ThaoMinhHoang/350_Flight_controller/README.md

# ECTE350 Flight controller
ECTE350 storage room for Locus team

Save the kicad files of your sensor. Put them into a folder. Name the folder after your sensor. Upload the folder to github.

The Development folder is all of our work in the one kicad file. Be careful when overwriting data!
