ThaoMinhHoang/350_Flight_controller/footprint/NX3225SA-24.000M-STD-CSR-3-pcb-part-libraries/LIB_GET/NX3225SA-24.000M-STD-CSR-3/3D/NX3225SA-24.000M-STD-CSR-3.stp

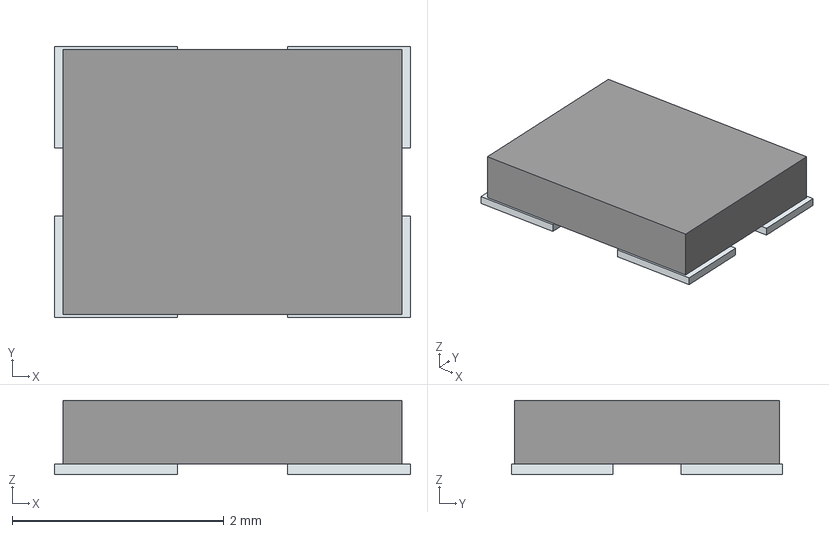
[picture p1: CAD file, 2019-08-31]
footprint/NX3225SA-24.000M-STD-CSR-3-pcb-part-libraries/LIB_GET/NX3225SA-24.000M-STD-CSR-3/3D/NX3225SA-24.000M-STD-CSR-3.stp
3.36 x 2.56 x 0.7 mm
('pin',_'1')
('pin',_'2')
('pin',_'3')
('pin',_'4')
