ThaoMinhHoang/350_Flight_controller/(list of files, cad)

Other CAD files:
footprint/NX3225SA-24.000M-STD-CSR-3-pcb-part-libraries/LIB_GET/NX3225SA-24.000M-STD-CSR-3/3D/NX3225SA-24.000M-STD-CSR-3.stl
footprint/NX3225SA-24.000M-STD-CSR-3-pcb-part-libraries/LIB_GET/NX3225SA-24.000M-STD-CSR-3/Allegro/nx3225sa12000mhzstdcsr1.psm
footprint/NX3225SA-24.000M-STD-CSR-3-pcb-part-libraries/LIB_GET/NX3225SA-24.000M-STD-CSR-3/DEHDL/nx3225sa_24.000m_std_csr_3/chips/chips.prt
footprint/NX3225SA-24.000M-STD-CSR-3-pcb-part-libraries/NX3225SA-24.000M-STD-CSR-3.stl
