ThaoMinhHoang/350_Flight_controller/Development/Flight_Controller.pdf

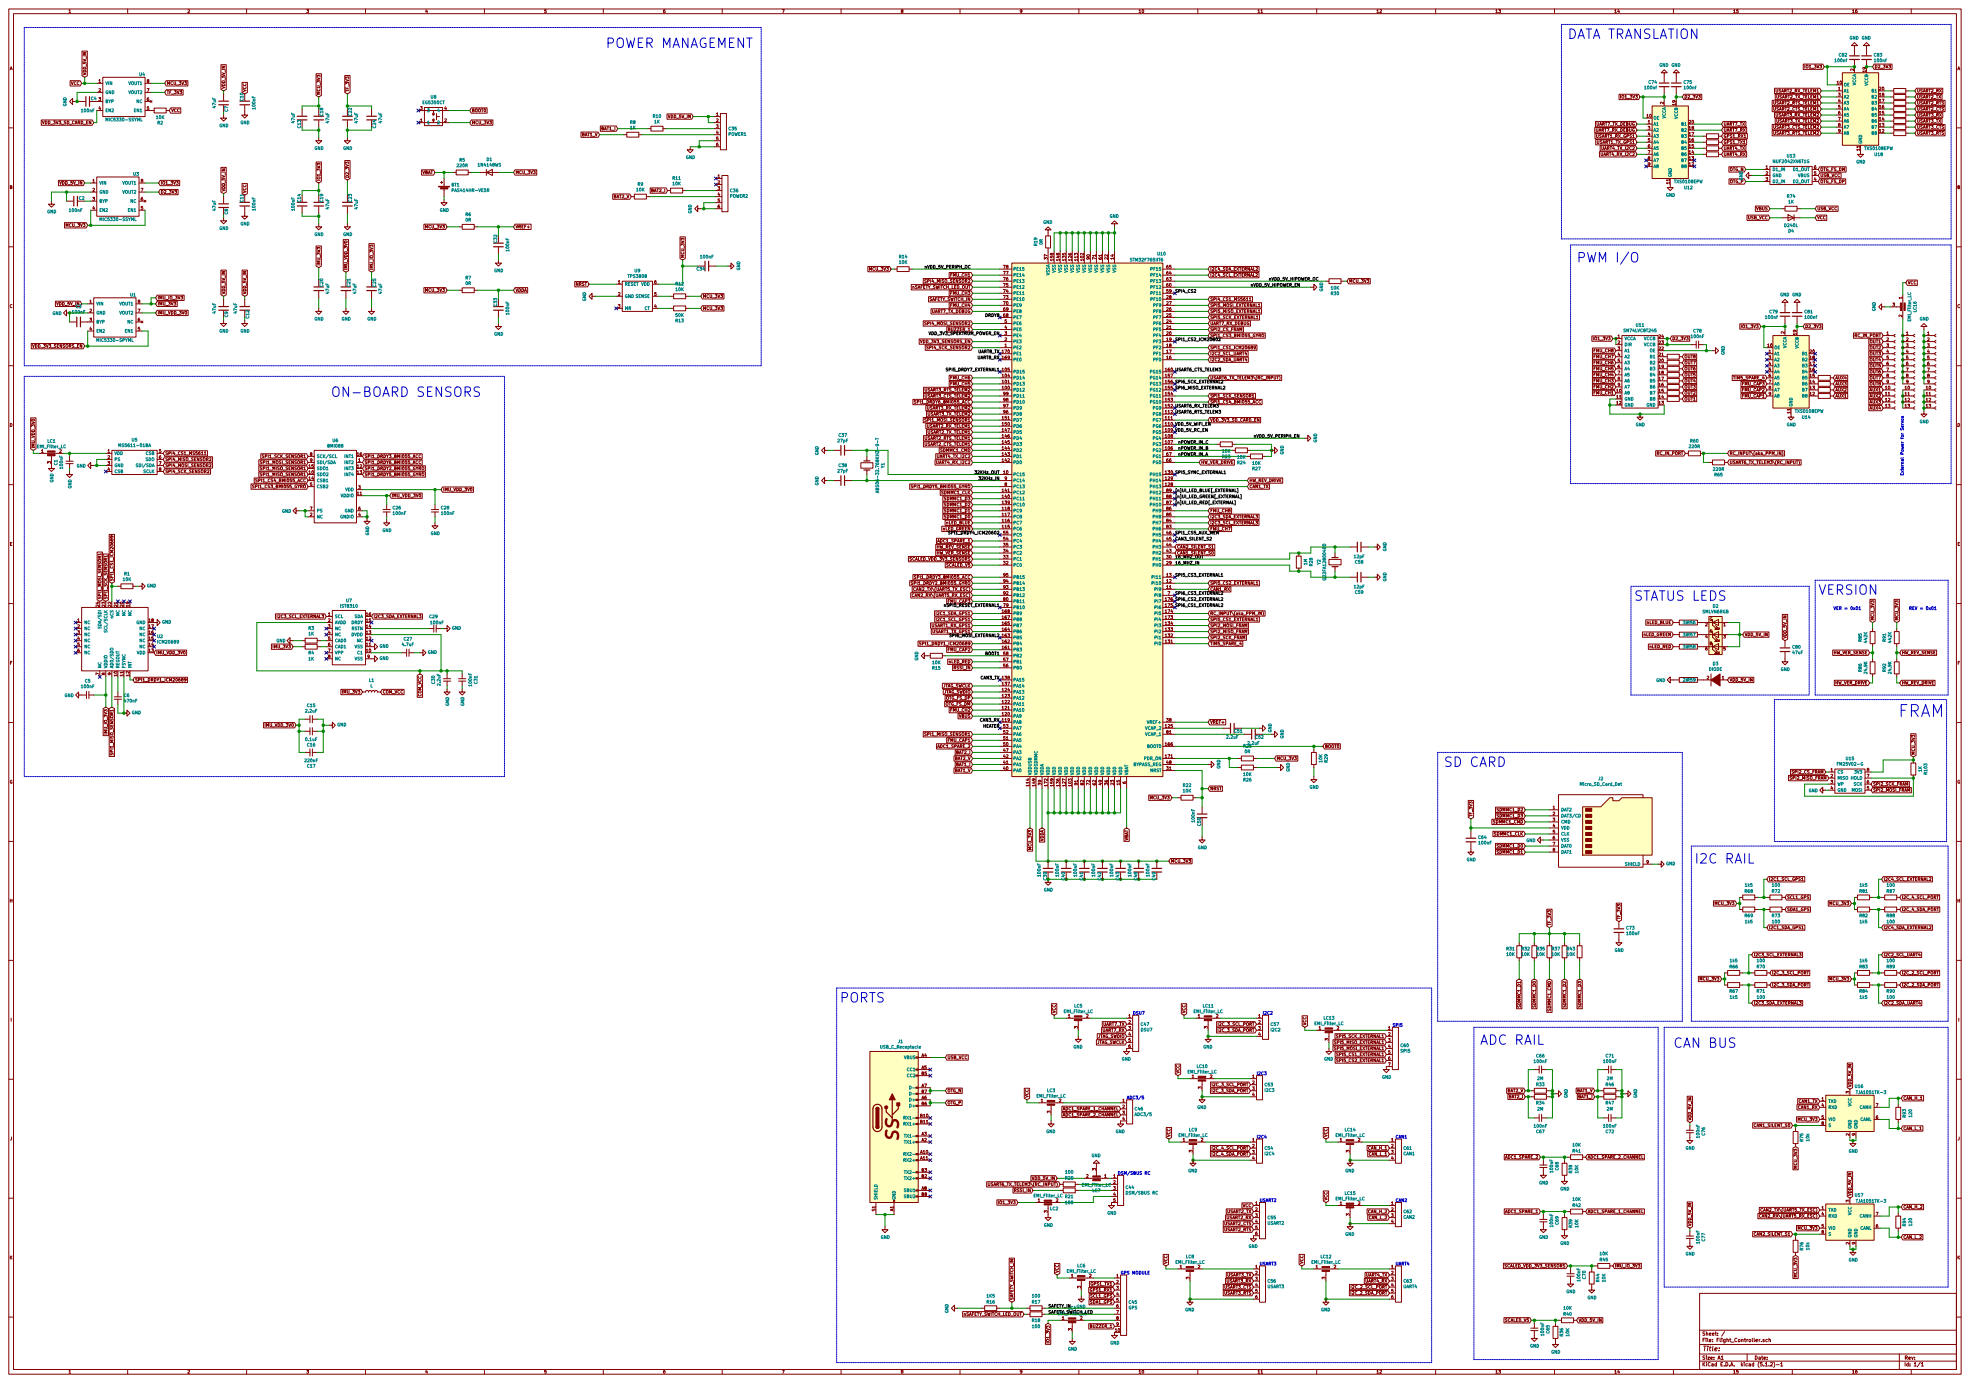
[picture p5: page 1]
