ThaoMinhHoang/350_Flight_controller/Development/Flight_Controller.kicad_pcb

## KiCad design Development/Flight_Controller.kicad_pcb (2019-10-13)

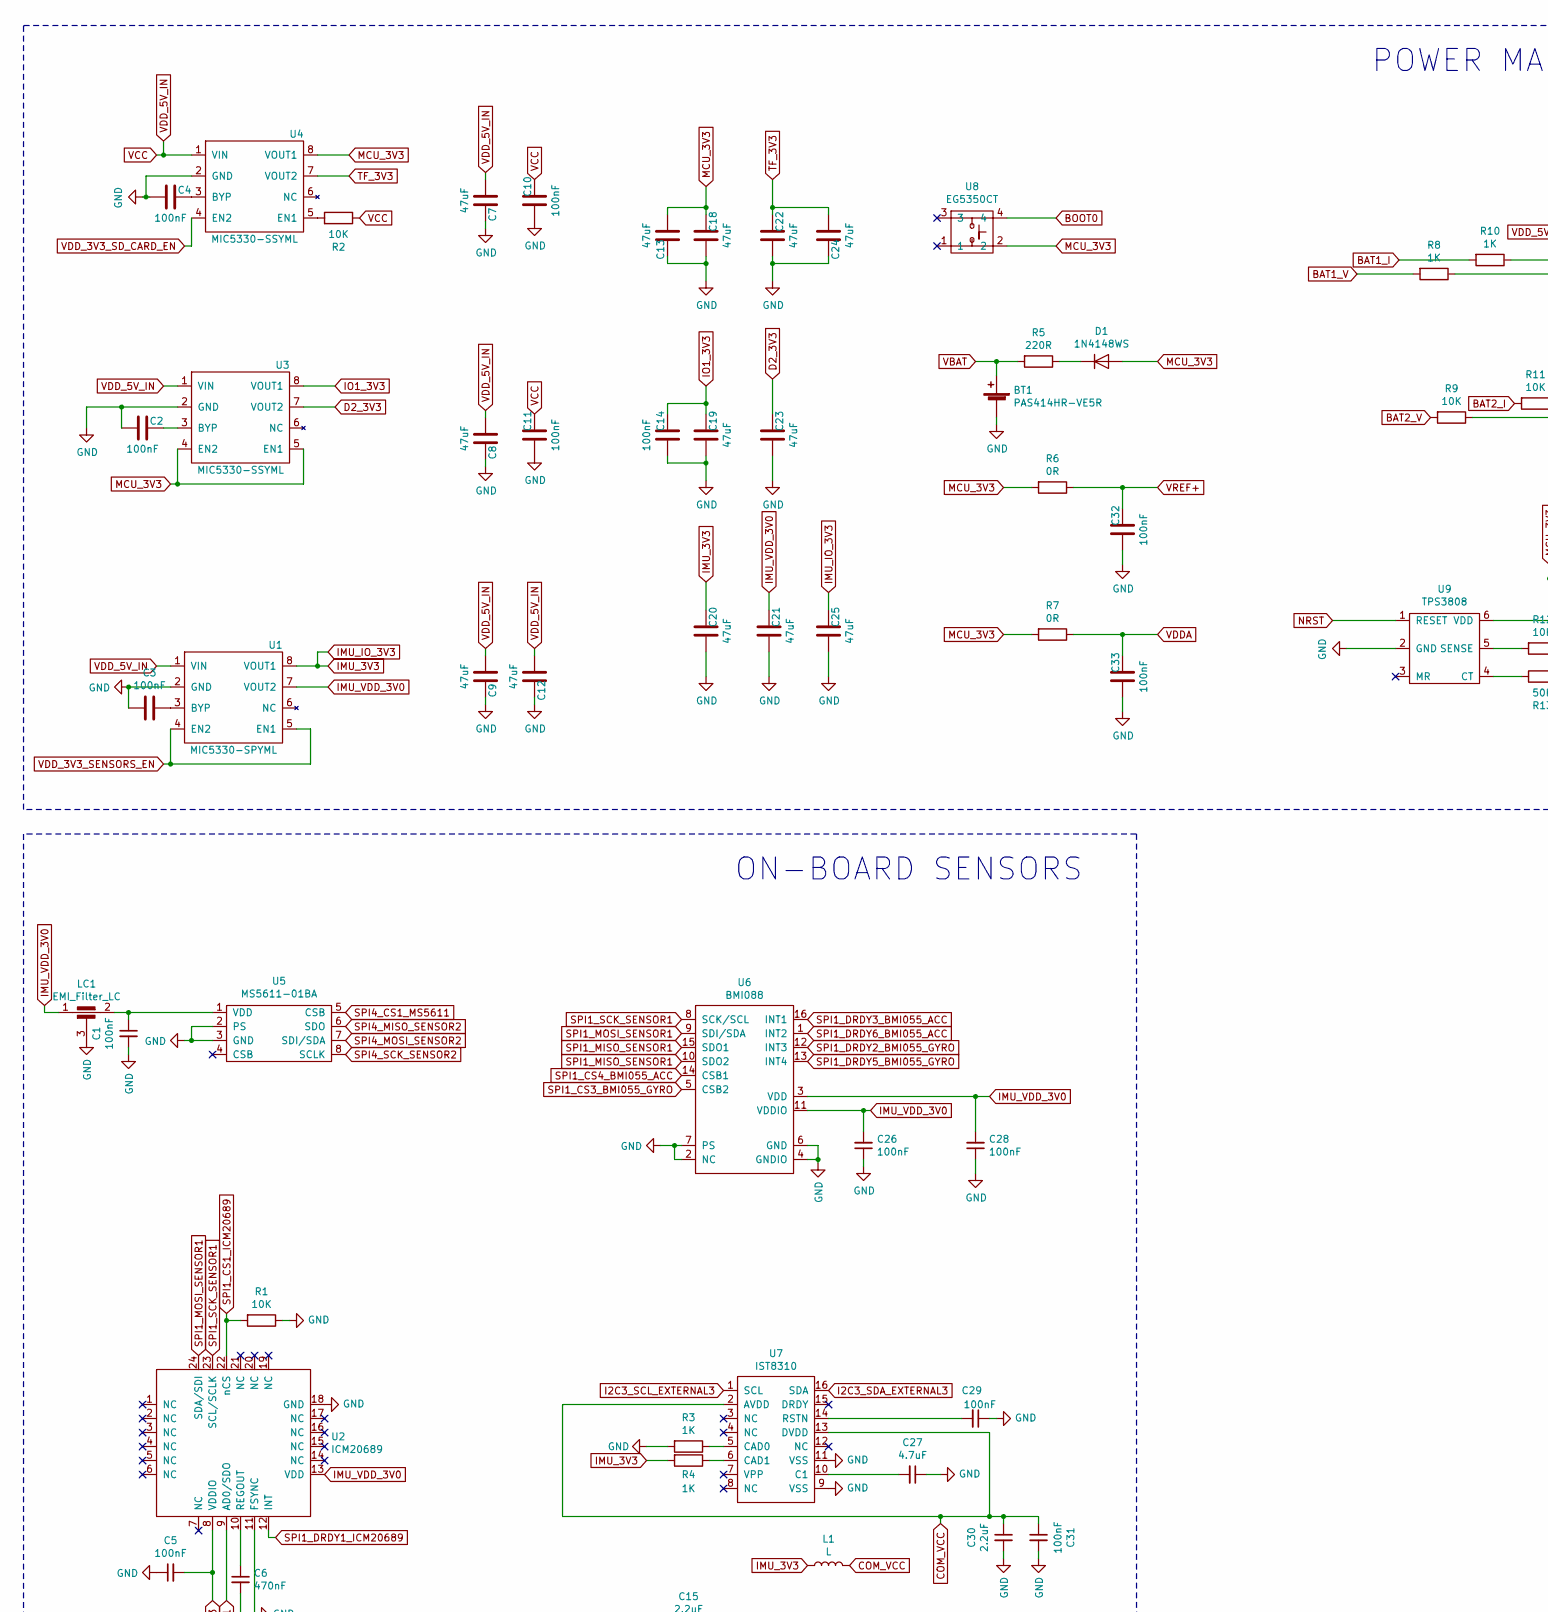
[picture p6: schematic Flight_Controller.sch, part in row 1, column 1]

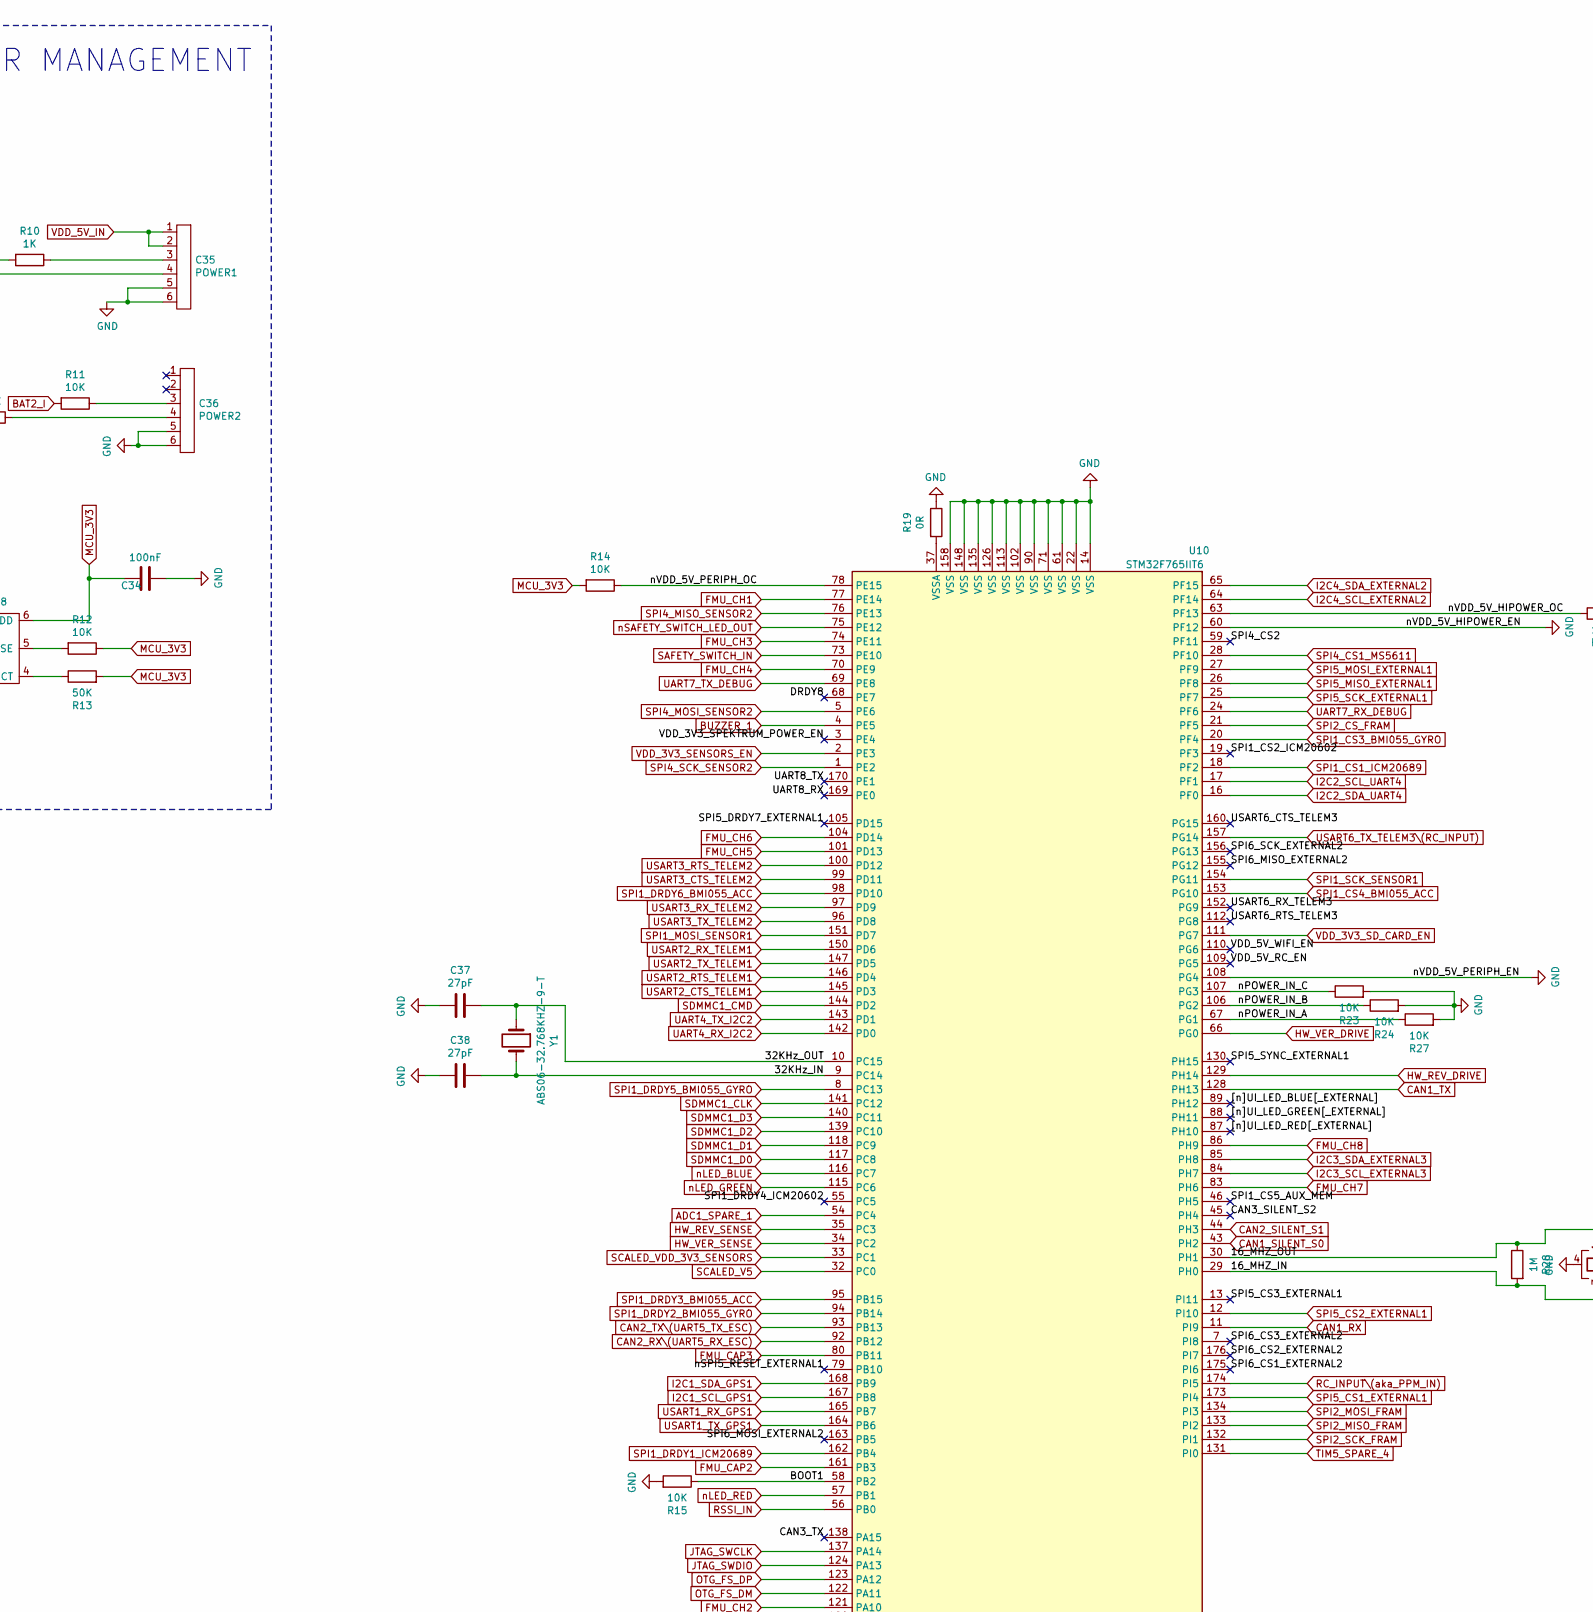
[picture p7: schematic Flight_Controller.sch, part in row 1, column 2]

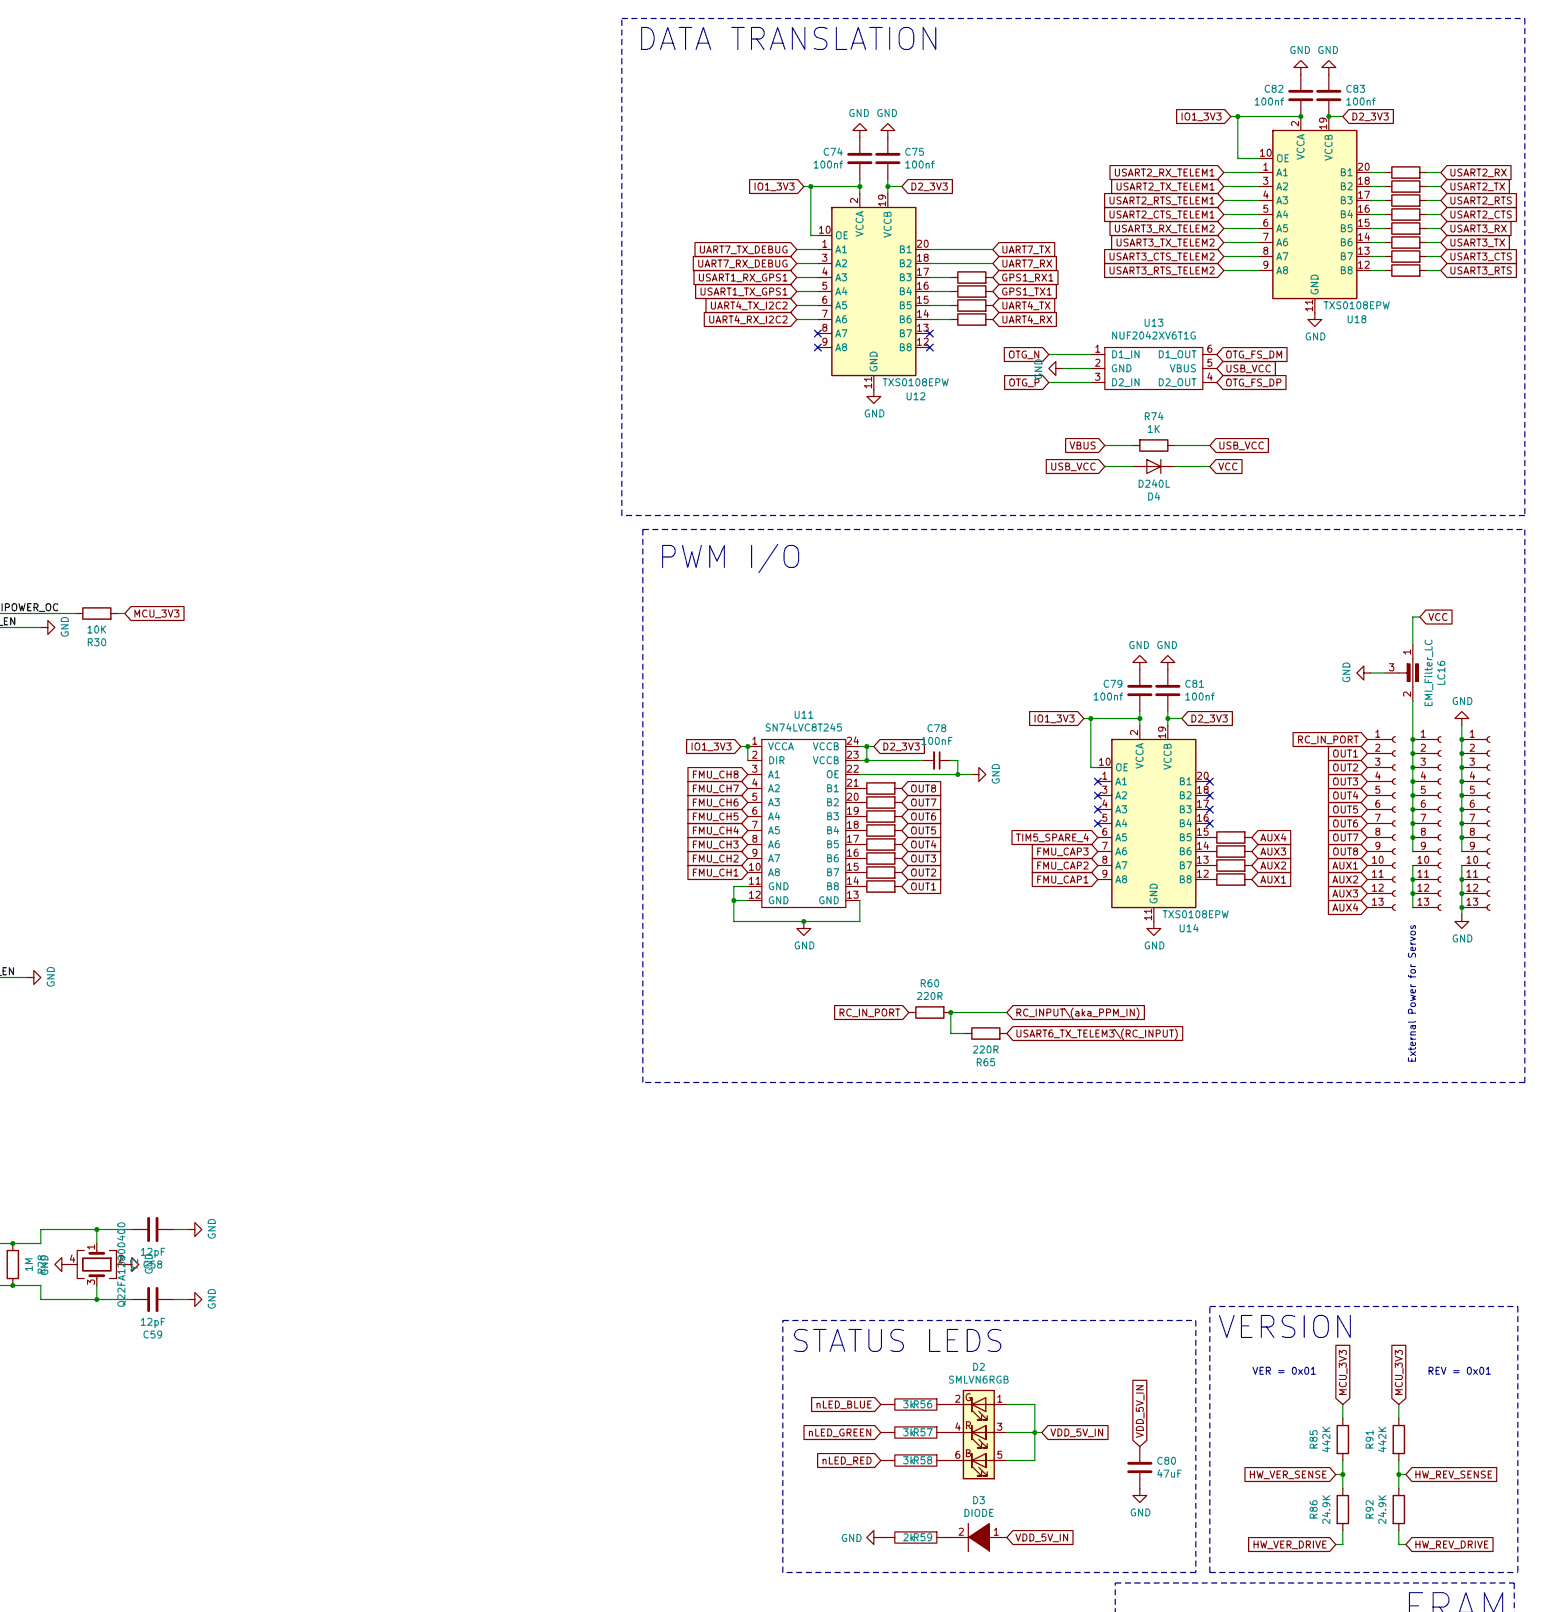
[picture p8: schematic Flight_Controller.sch, part in row 1, column 3]

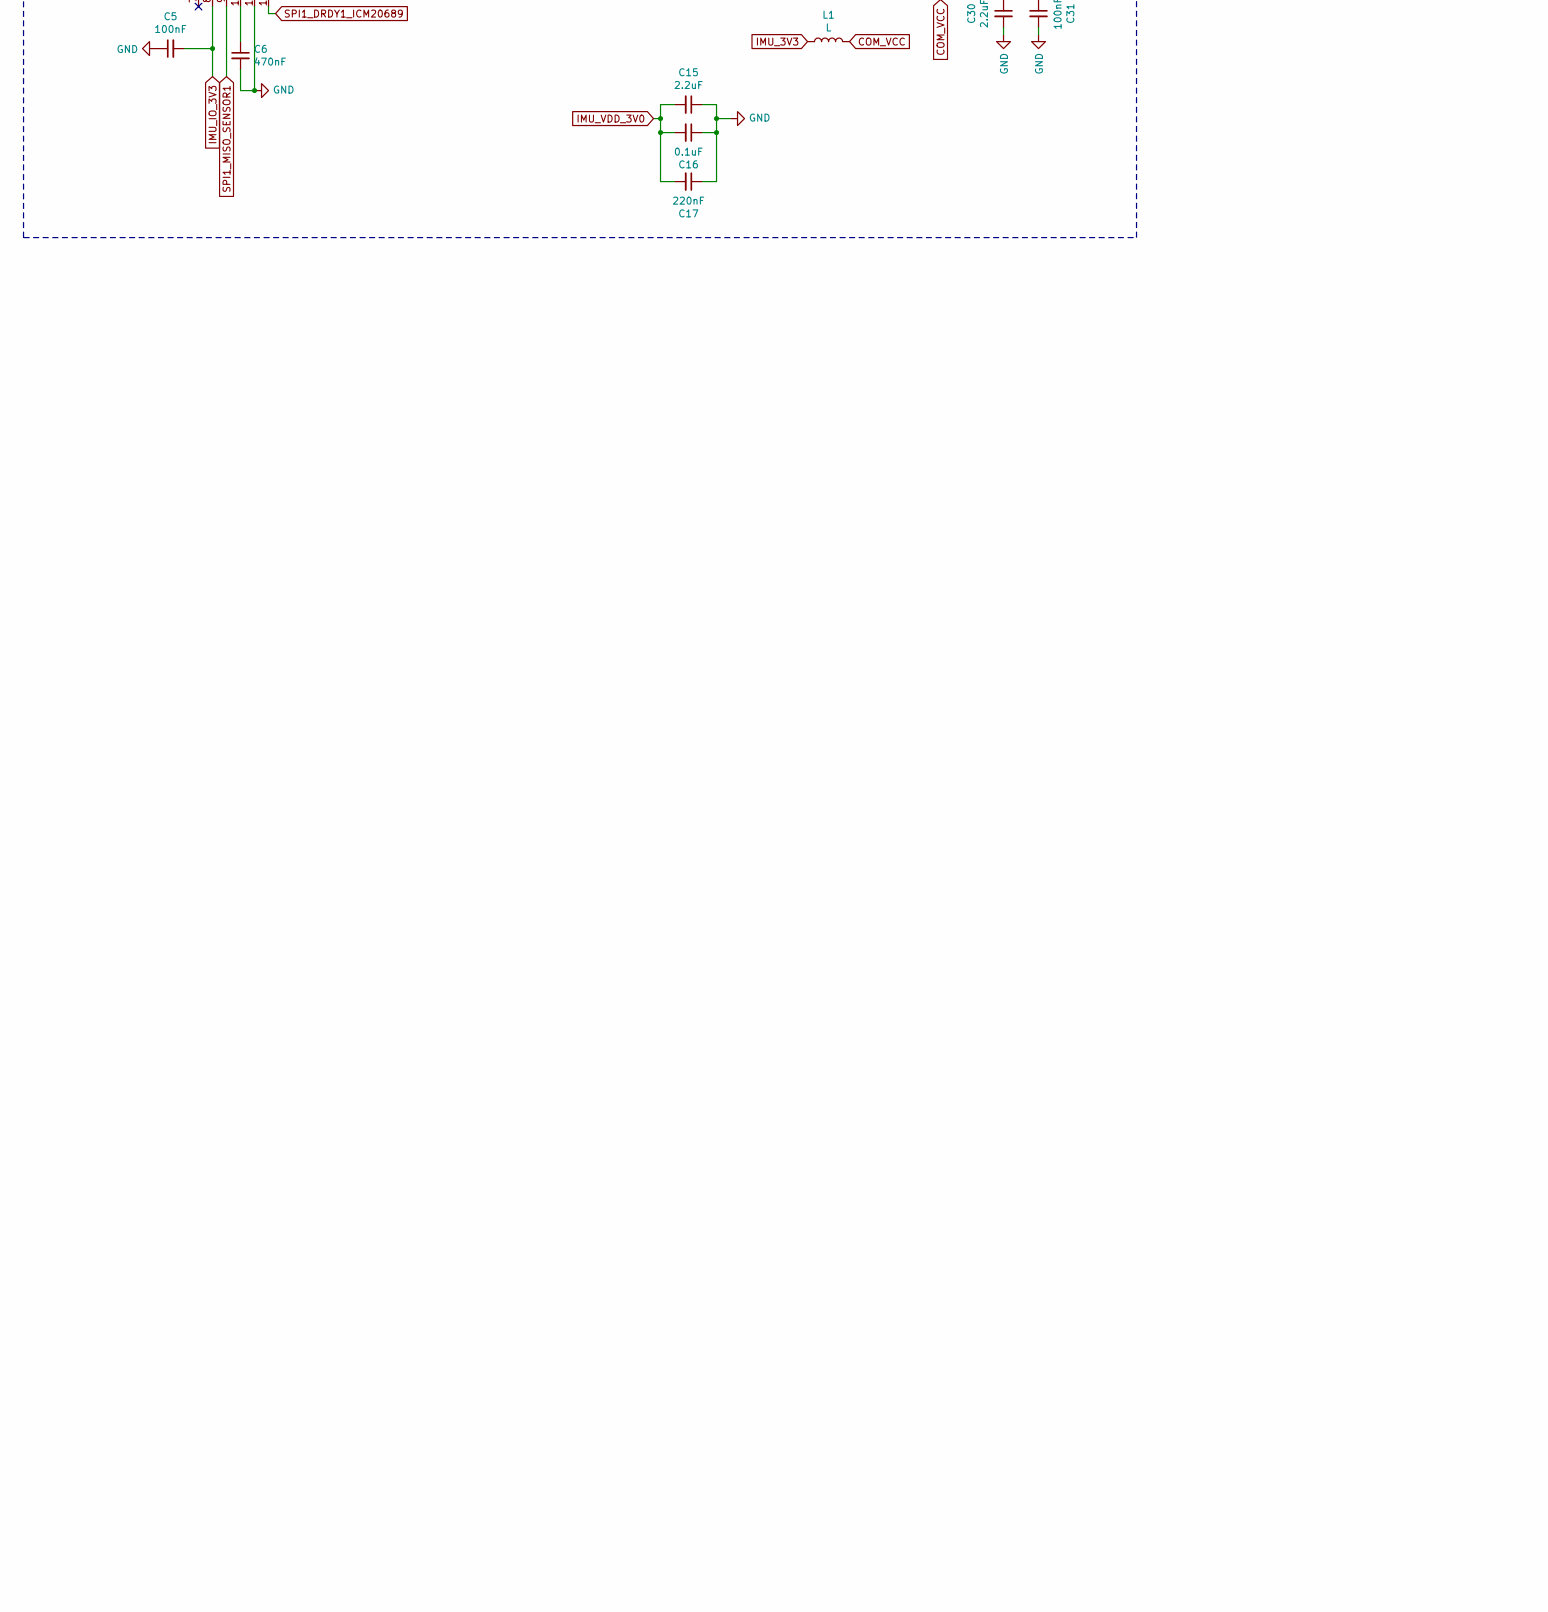
[picture p9: schematic Flight_Controller.sch, part in row 2, column 1]

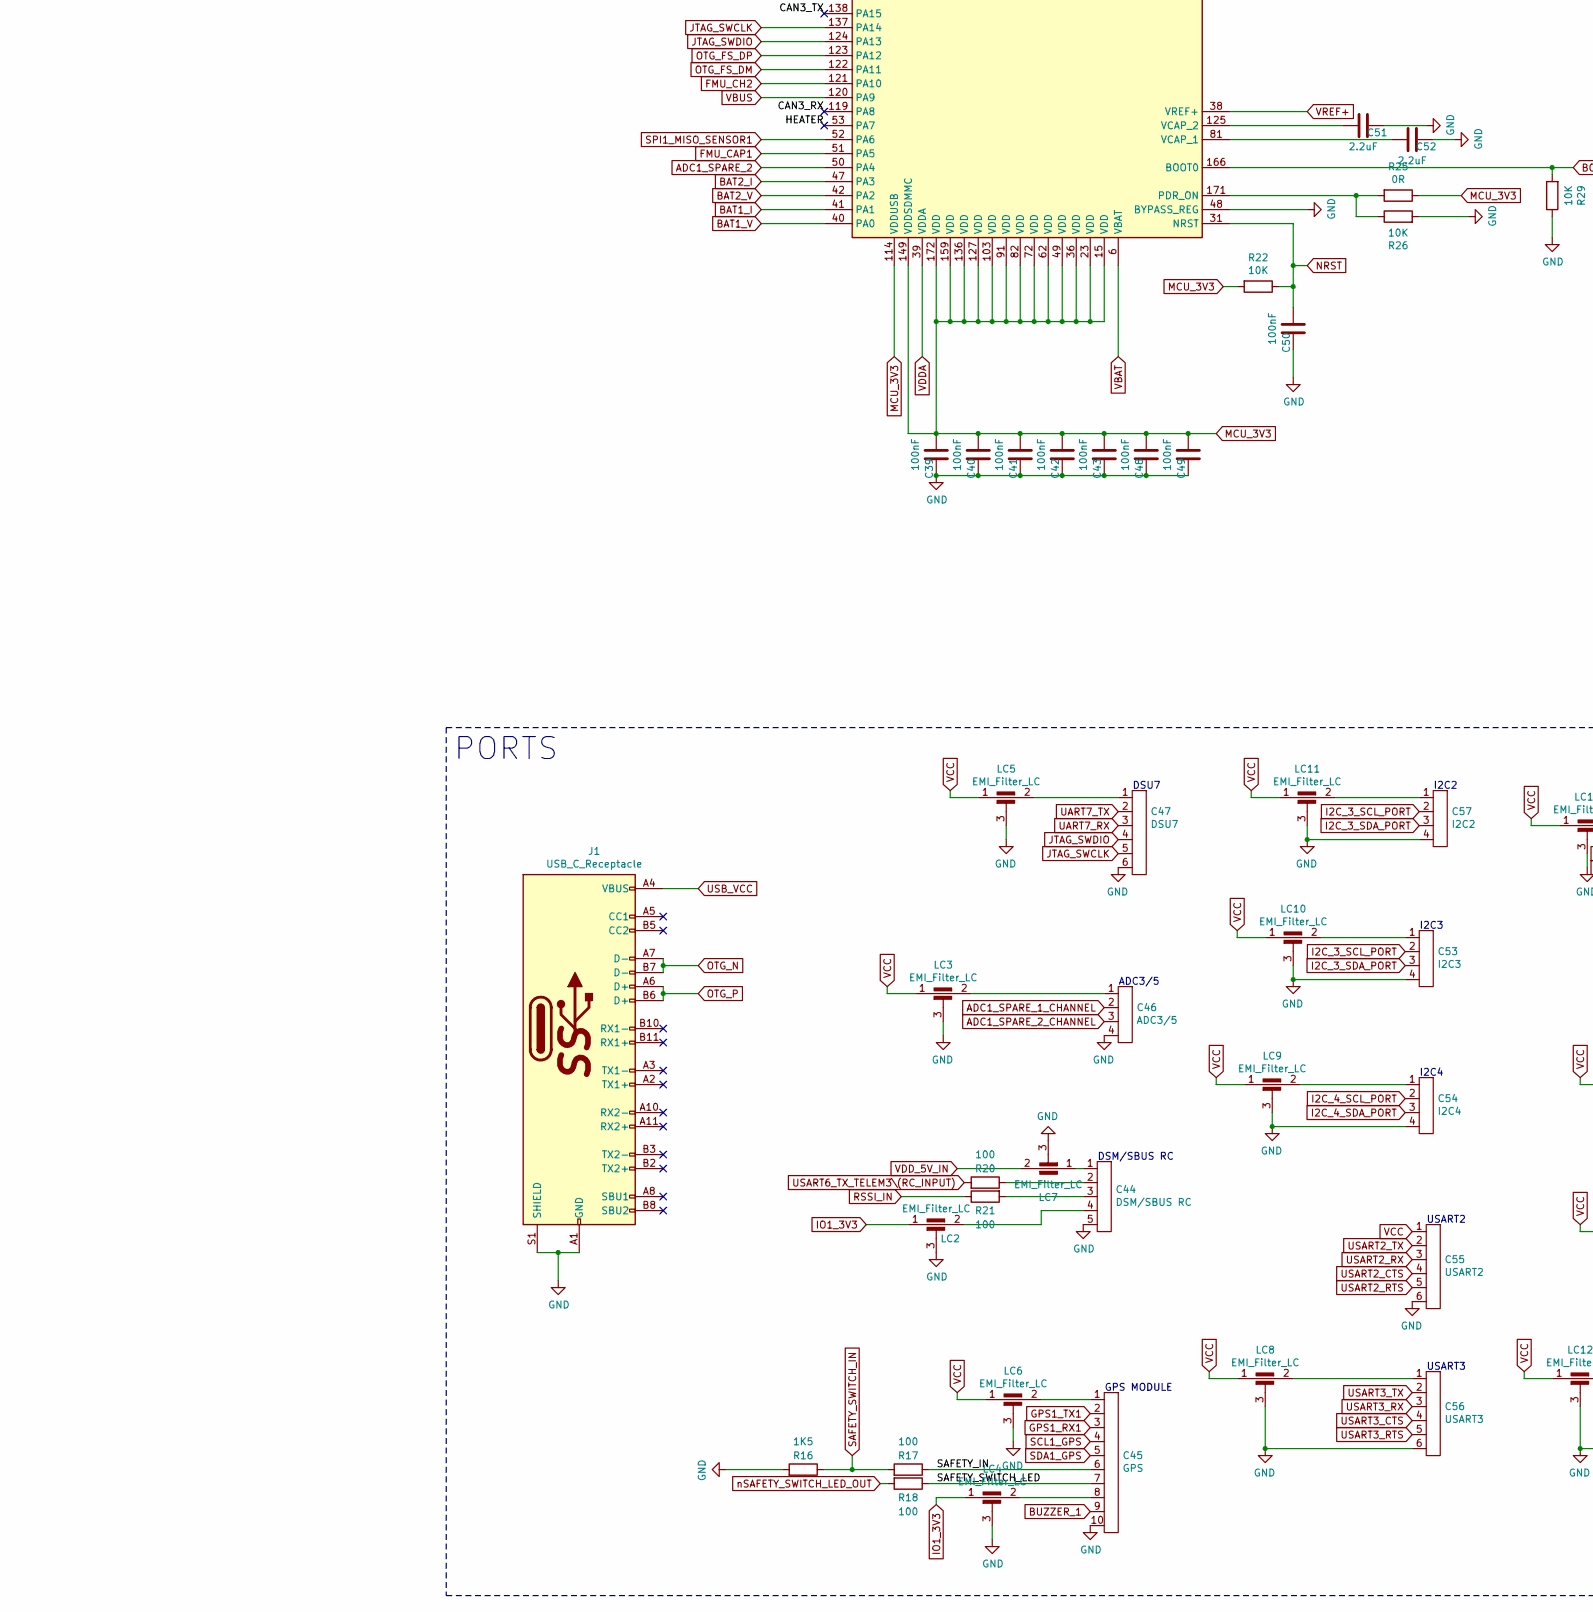
[picture p10: schematic Flight_Controller.sch, part in row 2, column 2]

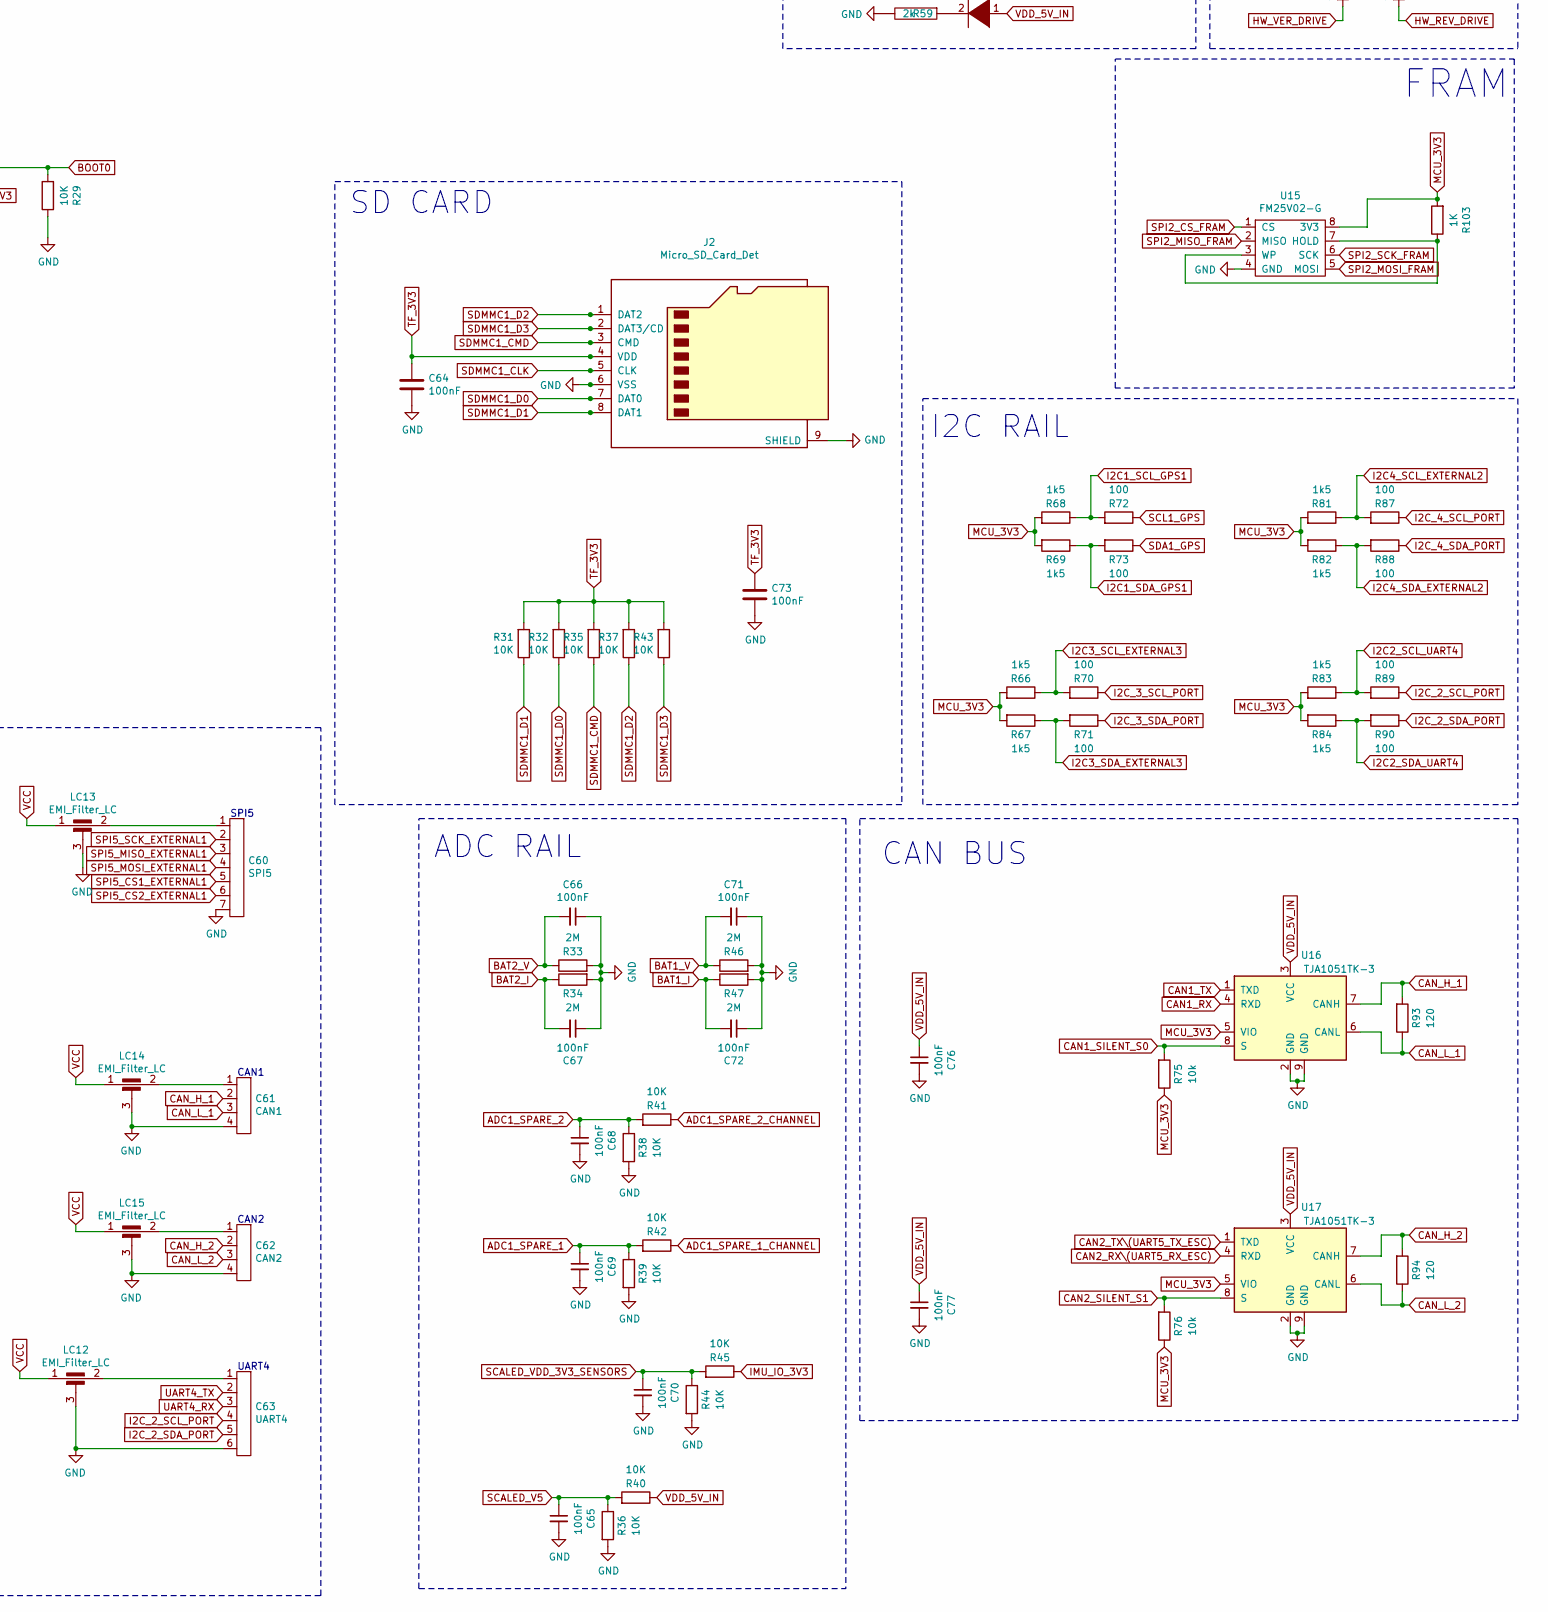
[picture p11: schematic Flight_Controller.sch, part in row 2, column 3]

Parts:
BT1: PAS414HR-VE5R; UL_PAS414HRVE5R
C1, C2, C3, C4, C5, C10, C11, C14, C26, C28, C29, C31, C32, C33, C34, C39, C40, C41, C42, C43, C48, C49, C50, C64, C65, C66, C67, C68, C69, C70, C71, C72, C73, C76, C77, C78: 100nF; C_0402_1005Metric
C6: 470nF; C_0402_1005Metric
C7, C8, C9, C12, C13, C18, C19, C20, C21, C22, C23, C24, C25, C80: 47uF; C_0603_1608Metric
C15, C30, C51, C52: 2.2uF; C_0402_1005Metric
C16: 0.1uF; C_0402_1005Metric
C17: 220nF; C_0402_1005Metric
C27: 4.7uF; C_0402_1005Metric
C35: POWER1; JST_GH_BM06B-GHS-TBT_06x1.25mm_Straight
C36: POWER2; JST_GH_BM06B-GHS-TBT_06x1.25mm_Straight
C37, C38: 27pF; C_0402_1005Metric
C44: DSM/SBUS RC; JST_GH_BM05B-GHS-TBT_05x1.25mm_Straight
C45: GPS; JST_GH_BM10B-GHS-TBT_10x1.25mm_Straight
C46: ADC3/5; JST_GH_BM04B-GHS-TBT_04x1.25mm_Straight
C47: DSU7; JST_GH_BM06B-GHS-TBT_06x1.25mm_Straight
C53: I2C3; JST_GH_BM04B-GHS-TBT_04x1.25mm_Straight
C54: I2C4; JST_GH_BM04B-GHS-TBT_04x1.25mm_Straight
C55: USART2; JST_GH_BM06B-GHS-TBT_06x1.25mm_Straight
C56: USART3; JST_GH_BM06B-GHS-TBT_06x1.25mm_Straight
C57: I2C2; JST_GH_BM04B-GHS-TBT_04x1.25mm_Straight
C58, C59: 12pF; C_0402_1005Metric
C60: SPI5; JST_GH_BM07B-GHS-TBT_07x1.25mm_Straight
C61: CAN1; JST_GH_BM04B-GHS-TBT_04x1.25mm_Straight
C62: CAN2; JST_GH_BM04B-GHS-TBT_04x1.25mm_Straight
C63: UART4; JST_GH_BM06B-GHS-TBT_06x1.25mm_Straight
C74, C75, C79, C81, C82, C83: 100nf; C_0402_1005Metric
D1: 1N4148WS; D_SOD-323
D2: SMLVN6RGB; LED_ROHM_SMLVN6
D3: DIODE; LED_0603_1608Metric
D4: D240L; D_SOD-123
J1: USB_C_Receptacle; USB_C_Receptacle_Amphenol_12401610E4-2A_CircularHoles
J2: Micro_SD_Card_Det; microSD_HC_Hirose_DM3AT-SF-PEJM5
J3, J4, J5: Conn_01x13_Female; PinHeader_1x13_P2.54mm_Vertical
L1: L; L_0402_1005Metric
LC1, LC2, LC3, LC4, LC5, LC6, LC7, LC8, LC9, LC10, LC11, LC12, LC13, LC14, LC15, LC16: EMI_Filter_LC; FIL_NFM21PC105B1C3D
R1, R2, R9, R11, R12, R14, R15, R22, R23, R24, R26, R27, R29, R30, R31, R32, R35, R36, R37, R38, R39, R40, R41, R42, R43, R44, R45: 10K; R_0402_1005Metric
R3, R4, R8, R10, R74, R103: 1K; R_0402_1005Metric
R5, R60, R65: 220R; R_0402_1005Metric
R6, R7, R19, R25: 0R; R_0402_1005Metric
R13: 50K; R_0402_1005Metric
R16: 1K5; R_0402_1005Metric
R17, R18, R20, R21, R48, R49, R50, R51, R52, R53, R54, R55, R70, R71, R72, R73, R77, R78, R79, R80, R87, R88, R89, R90: 100; R_0402_1005Metric
R28: 1M; R_0402_1005Metric
R33, R34, R46, R47: 2M; R_0402_1005Metric
R56, R57, R58: 3k; R_0402_1005Metric
R59: 2k; R_0402_1005Metric
R61, R62, R63, R64, R95, R96, R97, R98, R99, R100, R101, R102: 100R; R_0402_1005Metric
R66, R67, R68, R69, R81, R82, R83, R84: 1k5; R_0402_1005Metric
R75, R76: 10k; R_0402_1005Metric
R85, R91: 442K; R_0402_1005Metric
R86, R92: 24.9K; R_0402_1005Metric
R93, R94: 120; R_0402_1005Metric
U1: MIC5330-SPYML; MIC5330-SSYML-TR
U2: ICM20689
U3, U4: MIC5330-SSYML; MIC5330-SSYML-TR
U5: MS5611-01BA; ms5611
U6: BMI088
U7: IST8310; ist8310
U8: EG5350CT; SW_SPST_EVQP7C
U9: TPS3808; SOT95P280X145-6N
U10: STM32F765IIT6; LQFP-176_24x24mm_P0.5mm
U11: SN74LVC8T245; SOP65P640X120-24N
U12, U14, U18: TXS0108EPW; TSSOP-20_4.4x6.5mm_P0.65mm
U13: NUF2042XV6T1G; SOT50P160X60-6N
U15: FM25V02-G
U16, U17: TJA1051TK-3; DFN-8-1EP_3x3mm_P0.65mm_EP1.55x2.4mm
Y1: ABS06-32.768KHZ-9-T; XTAL_ABS06-32.768KHZ-9-T
Y2: Q22FA12800400

Connections:
/16_MHZ_IN: C59.1, R28.2, U10.29 (PH0), Y2.3
/16_MHZ_OUT: C58.1, R28.1, U10.30 (PH1), Y2.1
/32KHz_IN: C38.1, U10.9 (PC14), Y1.2
/32KHz_OUT: C37.1, U10.10 (PC15), Y1.1
/BOOT1: R15.1, U10.58 (PB2)
/CAN3_RX: U10.119 (PA8)
/CAN3_SILENT_S2: U10.45 (PH4)
/CAN3_TX: U10.138 (PA15)
/DRDY8: U10.68 (PE7)
/HEATER: U10.53 (PA7)
/SAFETY_IN: C45.6, R17.1
/SAFETY_SWITCH_LED: C45.7, R18.1
/SPI1_CS2_ICM20602: U10.19 (PF3)
/SPI1_CS5_AUX_MEM: U10.46 (PH5)
/SPI1_DRDY4_ICM20602: U10.55 (PC5)
/SPI4_CS2: U10.59 (PF11)
/SPI5_CS3_EXTERNAL1: U10.13 (PI11)
/SPI5_DRDY7_EXTERNAL1: U10.105 (PD15)
/SPI5_SYNC_EXTERNAL1: U10.130 (PH15)
/SPI6_CS1_EXTERNAL2: U10.175 (PI6)
/SPI6_CS2_EXTERNAL2: U10.176 (PI7)
/SPI6_CS3_EXTERNAL2: U10.7 (PI8)
/SPI6_MISO_EXTERNAL2: U10.155 (PG12)
/SPI6_MOSI_EXTERNAL2: U10.163 (PB5)
/SPI6_SCK_EXTERNAL2: U10.156 (PG13)
/UART8_RX: U10.169 (PE0)
/UART8_TX: U10.170 (PE1)
/USART6_CTS_TELEM3: U10.160 (PG15)
/USART6_RTS_TELEM3: U10.112 (PG8)
/USART6_RX_TELEM3: U10.152 (PG9)
/VDD_3V3_SPEKTRUM_POWER_EN: U10.3 (PE4)
/VDD_5V_RC_EN: U10.109 (PG5)
/VDD_5V_WIFI_EN: U10.110 (PG6)
/[n]UI_LED_BLUE[_EXTERNAL]: U10.89 (PH12)
/[n]UI_LED_GREEN[_EXTERNAL]: U10.88 (PH11)
/[n]UI_LED_RED[_EXTERNAL]: U10.87 (PH10)
/nPOWER_IN_A: R27.1, U10.67 (PG1)
/nPOWER_IN_B: R24.1, U10.106 (PG2)
/nPOWER_IN_C: R23.1, U10.107 (PG3)
/nSPI5_RESET_EXTERNAL1: U10.79 (PB10)
/nVDD_5V_HIPOWER_OC: R30.1, U10.63 (PF13)
/nVDD_5V_PERIPH_OC: R14.1, U10.78 (PE15)
ADC1_SPARE_1: C69.1, R39.1, R42.2, U10.54 (PC4)
ADC1_SPARE_1_CHANNEL: C46.2, R42.1
ADC1_SPARE_2: C68.1, R38.1, R41.2, U10.50 (PA4)
ADC1_SPARE_2_CHANNEL: C46.3, R41.1
AUX1: J3.10, R80.2
AUX2: J3.11, R79.2
AUX3: J3.12, R78.2
AUX4: J3.13, R77.2
BAT1_I: C72.2, R10.2, R47.1, U10.41 (PA1)
BAT1_V: C71.2, R8.2, R46.1, U10.40 (PA0)
BAT2_I: C67.2, R11.2, R34.1, U10.47 (PA3)
BAT2_V: C66.2, R9.2, R33.1, U10.42 (PA2)
BOOT0: R29.2, U8.4, U10.166 (BOOT0)
BUZZER_1: C45.9, U10.4 (PE5)
CAN1_RX: U10.11 (PI9), U16.4 (RXD)
CAN1_SILENT_S0: R75.2, U10.43 (PH2), U16.8 (S)
CAN1_TX: U10.128 (PH13), U16.1 (TXD)
CAN2_RX\(UART5_RX_ESC): U10.92 (PB12), U17.4 (RXD)
CAN2_SILENT_S1: R76.2, U10.44 (PH3), U17.8 (S)
CAN2_TX\(UART5_TX_ESC): U10.93 (PB13), U17.1 (TXD)
CAN_H_1: C61.2, R93.2, U16.7 (CANH)
CAN_H_2: C62.2, R94.2, U17.7 (CANH)
CAN_L_1: C61.3, R93.1, U16.6 (CANL)
CAN_L_2: C62.3, R94.1, U17.6 (CANL)
COM_VCC: C30.1, C31.1, L1.2, U7.2 (AVDD), U7.13 (DVDD)
D2_3V3: C23.2, C75.2, C78.2, C81.2, C83.2, U3.7 (VOUT2), U11.23 (VCCB), U11.24 (VCCB), U12.19 (VCCB), U14.19 (VCCB), U18.19 (VCCB)
FMU_CAP1: U10.51 (PA5), U14.9 (A8)
FMU_CAP2: U10.161 (PB3), U14.8 (A7)
FMU_CAP3: U10.80 (PB11), U14.7 (A6)
FMU_CH1: U10.77 (PE14), U11.10 (A8)
FMU_CH2: U10.121 (PA10), U11.9 (A7)
FMU_CH3: U10.74 (PE11), U11.8 (A6)
FMU_CH4: U10.70 (PE9), U11.7 (A5)
FMU_CH5: U10.101 (PD13), U11.6 (A4)
FMU_CH6: U10.104 (PD14), U11.5 (A3)
FMU_CH7: U10.83 (PH6), U11.4 (A2)
FMU_CH8: U10.86 (PH9), U11.3 (A1)
GND: BT1.2 (-), C1.2, C2.2, C3.1, C4.2, C5.1, C6.2, C7.1, C8.1, C9.1, C10.2, C11.2, C12.1, C13.2, C14.1, C15.1, C16.1, C17.1, C18.1, C19.1, C20.1, C21.1, C22.1, C23.1, C24.2, C25.1, C26.1, C27.1, C28.1, C29.1, C30.2, C31.2, C32.2, C33.2, C34.2, C35.5, C35.6, C36.5, C36.6, C37.2, C38.2, C39.2, C40.2, C41.2, C42.2, C43.2, C44.5, C45.10, C46.4, C47.6, C48.2, C49.2, C50.2, C51.2, C52.2, C53.4, C54.4, C55.6, C56.6, C57.4, C58.2, C59.2, C60.7, C61.4, C62.4, C63.6, C64.2, C65.2, C66.1, C67.1, C68.2, C69.2, C70.2, C71.1, C72.1, C73.2, C74.1, C75.1, C76.2, C77.2, C78.1, C79.1, C80.2, C81.1, C82.1, C83.1, J1.A1 (GND), J1.A12 (GND), J1.B1 (GND), J1.B12 (GND), J1.S1 (SHIELD), J2.6 (VSS), J2.9 (SHIELD), J5.1, J5.2, J5.3, J5.4, J5.5, J5.6, J5.7, J5.8, J5.9, J5.10, J5.11, J5.12, J5.13, LC1.3, LC2.3, LC3.3, LC4.3, LC5.3, LC6.3, LC7.3, LC8.3, LC9.3, LC10.3, LC11.3, LC12.3, LC13.3, LC14.3, LC15.3, LC16.3, R1.1, R3.2, R15.2, R16.2, R19.1, R23.2, R24.2, R26.2, R27.2, R29.1, R33.2, R34.2, R36.2, R38.2, R39.2, R44.2, R46.2, R47.2, R59.2, U1.2 (GND), U2.11 (FSYNC), U2.18 (GND), U3.2 (GND), U4.2 (GND), U5.2 (PS), U5.3 (GND), U6.2 (NC), U6.4 (GNDIO), U6.6 (GND), U6.7 (PS), U7.9 (VSS), U7.11 (VSS), U9.2 (GND), U10.14 (VSS), U10.22 (VSS), U10.48 (BYPASS_REG), U10.60 (PF12), U10.61 (VSS), U10.71 (VSS), U10.90 (VSS), U10.102 (VSS), U10.108 (PG4), U10.113 (VSS), U10.126 (VSS), U10.135 (VSS), U10.148 (VSS), U10.158 (VSS), U11.11 (GND), U11.12 (GND), U11.13 (GND), U11.22 (OE), U12.11 (GND), U13.2 (GND), U14.11 (GND), U15.4 (GND), U16.2 (GND), U16.9 (GND), U17.2 (GND), U17.9 (GND), U18.11 (GND), Y2.2, Y2.4
GPS1_RX1: C45.3, R61.2
GPS1_TX1: C45.2, R62.2
HW_REV_DRIVE: R92.2, U10.129 (PH14)
HW_REV_SENSE: R91.2, R92.1, U10.35 (PC3)
HW_VER_DRIVE: R86.2, U10.66 (PG0)
HW_VER_SENSE: R85.2, R86.1, U10.34 (PC2)
I2C1_SCL_GPS1: R68.1, R72.2, U10.167 (PB8)
I2C1_SDA_GPS1: R69.1, R73.2, U10.168 (PB9)
I2C2_SCL_UART4: R83.1, R89.2, U10.17 (PF1)
I2C2_SDA_UART4: R84.1, R90.2, U10.16 (PF0)
I2C3_SCL_EXTERNAL3: R66.1, R70.2, U7.1 (SCL), U10.84 (PH7)
I2C3_SDA_EXTERNAL3: R67.1, R71.2, U7.16 (SDA), U10.85 (PH8)
I2C4_SCL_EXTERNAL2: R81.1, R87.2, U10.64 (PF14)
I2C4_SDA_EXTERNAL2: R82.1, R88.2, U10.65 (PF15)
I2C_2_SCL_PORT: C63.4, R89.1
I2C_2_SDA_PORT: C63.5, R90.1
I2C_3_SCL_PORT: C53.2, C57.2, R70.1
I2C_3_SDA_PORT: C53.3, C57.3, R71.1
I2C_4_SCL_PORT: C54.2, R87.1
I2C_4_SDA_PORT: C54.3, R88.1
IMU_3V3: C5.2, C20.2, C25.2, L1.1, R4.2, R45.1, U1.8 (VOUT1), U2.8 (VDDIO)
IMU_VDD_3V0: C15.2, C16.2, C17.2, C21.2, C26.2, C28.2, LC1.1, U1.7 (VOUT2), U2.13 (VDD), U6.3 (VDD), U6.11 (VDDIO)
IO1_3V3: C14.2, C19.2, C74.2, C79.2, C82.2, LC2.1, LC4.1, U3.8 (VOUT1), U11.1 (VCCA), U11.2 (DIR), U12.2 (VCCA), U12.10 (OE), U14.2 (VCCA), U14.10 (OE), U18.2 (VCCA), U18.10 (OE)
JTAG_SWCLK: C47.5, U10.137 (PA14)
JTAG_SWDIO: C47.4, U10.124 (PA13)
MCU_3V3: C13.1, C18.2, C34.1, C39.1, C40.1, C41.1, C42.1, C43.1, C48.1, C49.1, D1.2 (A), R6.2, R7.2, R12.1, R13.2, R14.2, R22.2, R25.1, R30.2, R66.2, R67.2, R68.2, R69.2, R75.1, R76.1, R81.2, R82.2, R83.2, R84.2, R85.1, R91.1, R103.2, U3.4 (EN2), U3.5 (EN1), U4.8 (VOUT1), U8.2, U9.6 (VDD), U10.15 (VDD), U10.23 (VDD), U10.36 (VDD), U10.49 (VDD), U10.62 (VDD), U10.72 (VDD), U10.82 (VDD), U10.91 (VDD), U10.103 (VDD), U10.114 (VDDUSB), U10.127 (VDD), U10.136 (VDD), U10.149 (VDDSDMMC), U10.159 (VDD), U10.172 (VDD), U15.8 (3V3), U16.5 (VIO), U17.5 (VIO)
NRST: C50.1, R22.1, U9.1 (RESET), U10.31 (NRST)
unnamed: C1.1, LC1.2, U5.1 (VDD)
unnamed: C2.1, U3.3 (BYP)
unnamed: C3.2, U1.3 (BYP)
unnamed: C4.1, U4.3 (BYP)
unnamed: C6.1, U2.10 (REGOUT)
unnamed: C27.2, U7.10 (C1)
unnamed: C29.2, U7.14 (RSTN)
unnamed: C35.3, R10.1
unnamed: C35.4, R8.1
unnamed: C36.3, R11.1
unnamed: C36.4, R9.1
unnamed: C44.1, LC7.1
unnamed: C44.2, R20.1
unnamed: C44.3, R21.2
unnamed: C44.4, LC2.2
unnamed: C45.1, LC6.2
unnamed: C45.8, LC4.2
unnamed: C46.1, LC3.2
unnamed: C47.1, LC5.2
unnamed: C51.1, U10.125 (VCAP_2)
unnamed: C52.1, U10.81 (VCAP_1)
unnamed: C53.1, LC10.2
unnamed: C54.1, LC9.2
unnamed: C56.1, LC8.2
unnamed: C57.1, LC11.2
unnamed: C60.1, LC13.2
unnamed: C61.1, LC14.2
unnamed: C62.1, LC15.2
unnamed: C63.1, LC12.2
unnamed: D1.1 (K), R5.1
unnamed: D2.2 (GK), R56.1
unnamed: D2.4 (RK), R57.1
unnamed: D2.6 (BK), R58.1
unnamed: D3.2 (A), R59.1
unnamed: J4.1, J4.2, J4.3, J4.4, J4.5, J4.6, J4.7, J4.8, J4.9, LC16.2
unnamed: J4.10, J4.11, J4.12, J4.13
unnamed: R2.2, U4.5 (EN1)
unnamed: R3.1, U7.5 (CAD0)
unnamed: R4.1, U7.6 (CAD1)
unnamed: R12.2, U9.5 (SENSE)
unnamed: R13.1, U9.4 (CT)
unnamed: R19.2, U10.37 (VSSA)
unnamed: R25.2, R26.1, U10.171 (PDR_ON)
unnamed: R48.1, U11.21 (B1)
unnamed: R49.1, U11.20 (B2)
unnamed: R50.1, U11.19 (B3)
unnamed: R51.1, U11.18 (B4)
unnamed: R52.1, U11.17 (B5)
unnamed: R53.1, U11.16 (B6)
unnamed: R54.1, U11.15 (B7)
unnamed: R55.1, U11.14 (B8)
unnamed: R61.1, U12.17 (B3)
unnamed: R62.1, U12.16 (B4)
unnamed: R63.1, U12.15 (B5)
unnamed: R64.1, U12.14 (B6)
unnamed: R77.1, U14.15 (B5)
unnamed: R78.1, U14.14 (B6)
unnamed: R79.1, U14.13 (B7)
unnamed: R80.1, U14.12 (B8)
unnamed: R95.1, U18.20 (B1)
unnamed: R96.1, U18.18 (B2)
unnamed: R97.1, U18.17 (B3)
unnamed: R98.1, U18.16 (B4)
unnamed: R99.1, U18.15 (B5)
unnamed: R100.1, U18.14 (B6)
unnamed: R101.1, U18.13 (B7)
unnamed: R102.1, U18.12 (B8)
unnamed: R103.1, U15.3 (WP), U15.7 (HOLD)
OTG_FS_DM: U10.122 (PA11), U13.6 (D1_OUT)
OTG_FS_DP: U10.123 (PA12), U13.4 (D2_OUT)
OTG_N: J1.A7 (D-), J1.B7 (D-), U13.1 (D1_IN)
OTG_P: J1.A6 (D+), J1.B6 (D+), U13.3 (D2_IN)
OUT1: J3.2, R55.2
OUT2: J3.3, R54.2
OUT3: J3.4, R53.2
OUT4: J3.5, R52.2
OUT5: J3.6, R51.2
OUT6: J3.7, R50.2
OUT7: J3.8, R49.2
OUT8: J3.9, R48.2
RC_INPUT\(aka_PPM_IN): R60.2, R65.1, U10.174 (PI5)
RC_IN_PORT: J3.1, R60.1
RSSI_IN: R21.1, U10.56 (PB0)
SAFETY_SWITCH_IN: R16.1, R17.2, U10.73 (PE10)
SCALED_V5: C65.1, R36.1, R40.2, U10.32 (PC0)
SCALED_VDD_3V3_SENSORS: C70.1, R44.1, R45.2, U10.33 (PC1)
SCL1_GPS: C45.4, R72.1
SDA1_GPS: C45.5, R73.1
SDMMC1_CLK: J2.5 (CLK), U10.141 (PC12)
SDMMC1_CMD: J2.3 (CMD), R35.1, U10.144 (PD2)
SDMMC1_D0: J2.7 (DAT0), R32.1, U10.117 (PC8)
SDMMC1_D1: J2.8 (DAT1), R31.1, U10.118 (PC9)
SDMMC1_D2: J2.1 (DAT2), R37.1, U10.139 (PC10)
SDMMC1_D3: J2.2 (DAT3/CD), R43.1, U10.140 (PC11)
SPI1_CS1_ICM20689: R1.2, U2.22 (nCS), U10.18 (PF2)
SPI1_CS3_BMI055_GYRO: U6.5 (CSB2), U10.20 (PF4)
SPI1_CS4_BMI055_ACC: U6.14 (CSB1), U10.153 (PG10)
SPI1_DRDY1_ICM20689: U2.12 (INT), U10.162 (PB4)
SPI1_DRDY2_BMI055_GYRO: U6.12 (INT3), U10.94 (PB14)
SPI1_DRDY3_BMI055_ACC: U6.16 (INT1), U10.95 (PB15)
SPI1_DRDY5_BMI055_GYRO: U6.13 (INT4), U10.8 (PC13)
SPI1_DRDY6_BMI055_ACC: U6.1 (INT2), U10.98 (PD10)
SPI1_MISO_SENSOR1: U2.9 (AD0/SDO), U6.10 (SDO2), U6.15 (SDO1), U10.52 (PA6)
SPI1_MOSI_SENSOR1: U2.24 (SDA/SDI), U6.9 (SDI/SDA), U10.151 (PD7)
SPI1_SCK_SENSOR1: U2.23 (SCL/SCLK), U6.8 (SCK/SCL), U10.154 (PG11)
SPI2_CS_FRAM: U10.21 (PF5), U15.1 (CS)
SPI2_MISO_FRAM: U10.133 (PI2), U15.2 (MISO)
SPI2_MOSI_FRAM: U10.134 (PI3), U15.5 (MOSI)
SPI2_SCK_FRAM: U10.132 (PI1), U15.6 (SCK)
SPI4_CS1_MS5611: U5.5 (CSB), U10.28 (PF10)
SPI4_MISO_SENSOR2: U5.6 (SDO), U10.76 (PE13)
SPI4_MOSI_SENSOR2: U5.7 (SDI/SDA), U10.5 (PE6)
SPI4_SCK_SENSOR2: U5.8 (SCLK), U10.1 (PE2)
SPI5_CS1_EXTERNAL1: C60.5, U10.173 (PI4)
SPI5_CS2_EXTERNAL1: C60.6, U10.12 (PI10)
SPI5_MISO_EXTERNAL1: C60.3, U10.26 (PF8)
SPI5_MOSI_EXTERNAL1: C60.4, U10.27 (PF9)
SPI5_SCK_EXTERNAL1: C60.2, U10.25 (PF7)
TF_3V3: C22.2, C24.1, C64.1, C73.1, J2.4 (VDD), R31.2, R32.2, R35.2, R37.2, R43.2, U4.7 (VOUT2)
TIM5_SPARE_4: U10.131 (PI0), U14.6 (A5)
UART4_RX: C63.3, R64.2
UART4_RX_I2C2: U10.142 (PD0), U12.7 (A6)
UART4_TX: C63.2, R63.2
UART4_TX_I2C2: U10.143 (PD1), U12.6 (A5)
UART7_RX: C47.3, U12.18 (B2)
UART7_RX_DEBUG: U10.24 (PF6), U12.3 (A2)
UART7_TX: C47.2, U12.20 (B1)
UART7_TX_DEBUG: U10.69 (PE8), U12.1 (A1)
USART1_RX_GPS1: U10.165 (PB7), U12.4 (A3)
USART1_TX_GPS1: U10.164 (PB6), U12.5 (A4)
USART2_CTS: C55.4, R98.2
USART2_CTS_TELEM1: U10.145 (PD3), U18.5 (A4)
USART2_RTS: C55.5, R97.2
USART2_RTS_TELEM1: U10.146 (PD4), U18.4 (A3)
USART2_RX: C55.3, R95.2
USART2_RX_TELEM1: U10.150 (PD6), U18.1 (A1)
USART2_TX: C55.2, R96.2
USART2_TX_TELEM1: U10.147 (PD5), U18.3 (A2)
USART3_CTS: C56.4, R101.2
USART3_CTS_TELEM2: U10.99 (PD11), U18.8 (A7)
USART3_RTS: C56.5, R102.2
USART3_RTS_TELEM2: U10.100 (PD12), U18.9 (A8)
USART3_RX: C56.3, R99.2
USART3_RX_TELEM2: U10.97 (PD9), U18.6 (A5)
USART3_TX: C56.2, R100.2
USART3_TX_TELEM2: U10.96 (PD8), U18.7 (A6)
USART6_TX_TELEM3\(RC_INPUT): R20.2, R65.2, U10.157 (PG14)
USB_VCC: D4.2 (A), J1.A4 (VBUS), J1.A9 (VBUS), J1.B4 (VBUS), J1.B9 (VBUS), R74.1, U13.5 (VBUS)
VBAT: BT1.1 (+), R5.2, U10.6 (VBAT)
VBUS: R74.2, U10.120 (PA9)
VCC: C7.2, C8.2, C9.2, C10.1, C11.1, C12.2, C35.1, C35.2, C55.1, C76.1, C77.1, C80.1, D2.1 (GA), D2.3 (RA), D2.5 (BA), D3.1 (K), D4.1 (K), LC3.1, LC5.1, LC6.1, LC7.2, LC8.1, LC9.1, LC10.1, LC11.1, LC12.1, LC13.1, LC14.1, LC15.1, LC16.1, R2.1, R40.1, U1.1 (VIN), U3.1 (VIN), U4.1 (VIN), U16.3 (VCC), U17.3 (VCC)
VDDA: C33.1, R7.1, U10.39 (VDDA)
VDD_3V3_SD_CARD_EN: U4.4 (EN2), U10.111 (PG7)
VDD_3V3_SENSORS_EN: U1.4 (EN2), U1.5 (EN1), U10.2 (PE3)
VREF+: C32.1, R6.1, U10.38 (VREF+)
nLED_BLUE: R56.2, U10.116 (PC7)
nLED_GREEN: R57.2, U10.115 (PC6)
nLED_RED: R58.2, U10.57 (PB1)
nSAFETY_SWITCH_LED_OUT: R18.2, U10.75 (PE12)

Notes on the sheet:
POWER MANAGEMENT
SPI5
FRAM
VER = 0x01
REV = 0x01
CAN BUS
I2C RAIL
VERSION
ADC RAIL
DATA TRANSLATION
PWM I/O
SD CARD
STATUS LEDS
I2C2
DSU7
ADC3/5
I2C3
USART2
USART3
UART4
I2C4
CAN1
CAN2
GPS MODULE
DSM/SBUS RC
PORTS
External Power for Servos
ON-BOARD SENSORS
