ThaoMinhHoang/350_Flight_controller/Development/Flight_Controller.kicad_pcb

## KiCad design Development/Flight_Controller.kicad_pcb (continued)

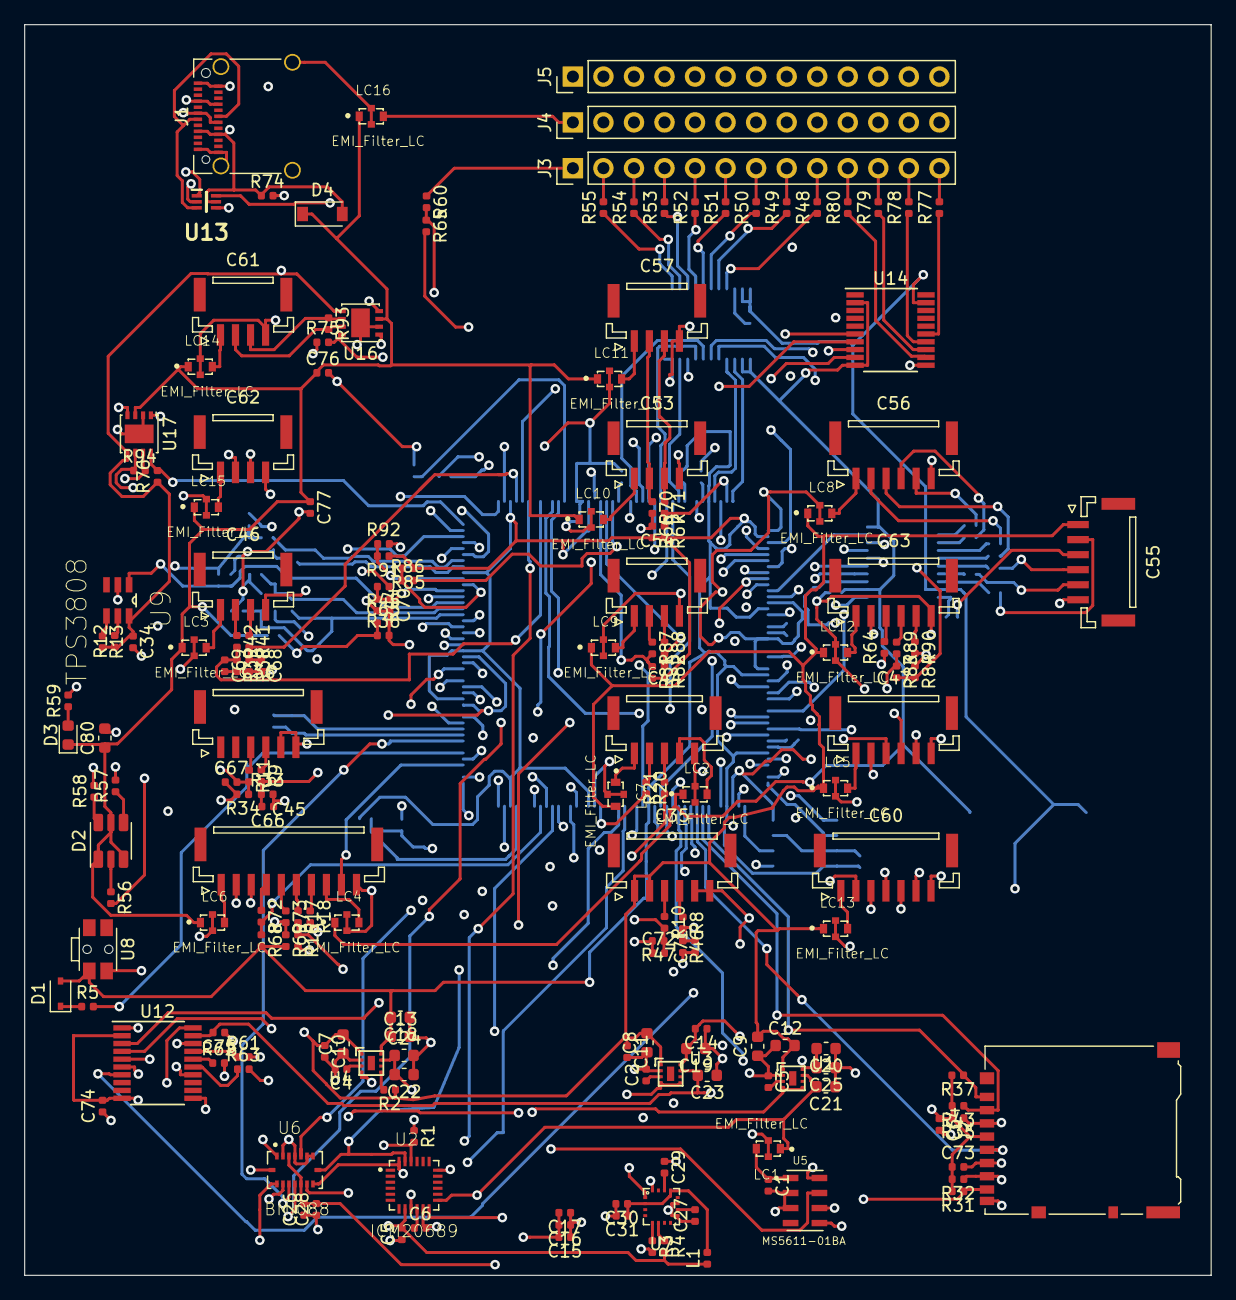
[picture p12: board Flight_Controller.kicad_pcb from above]

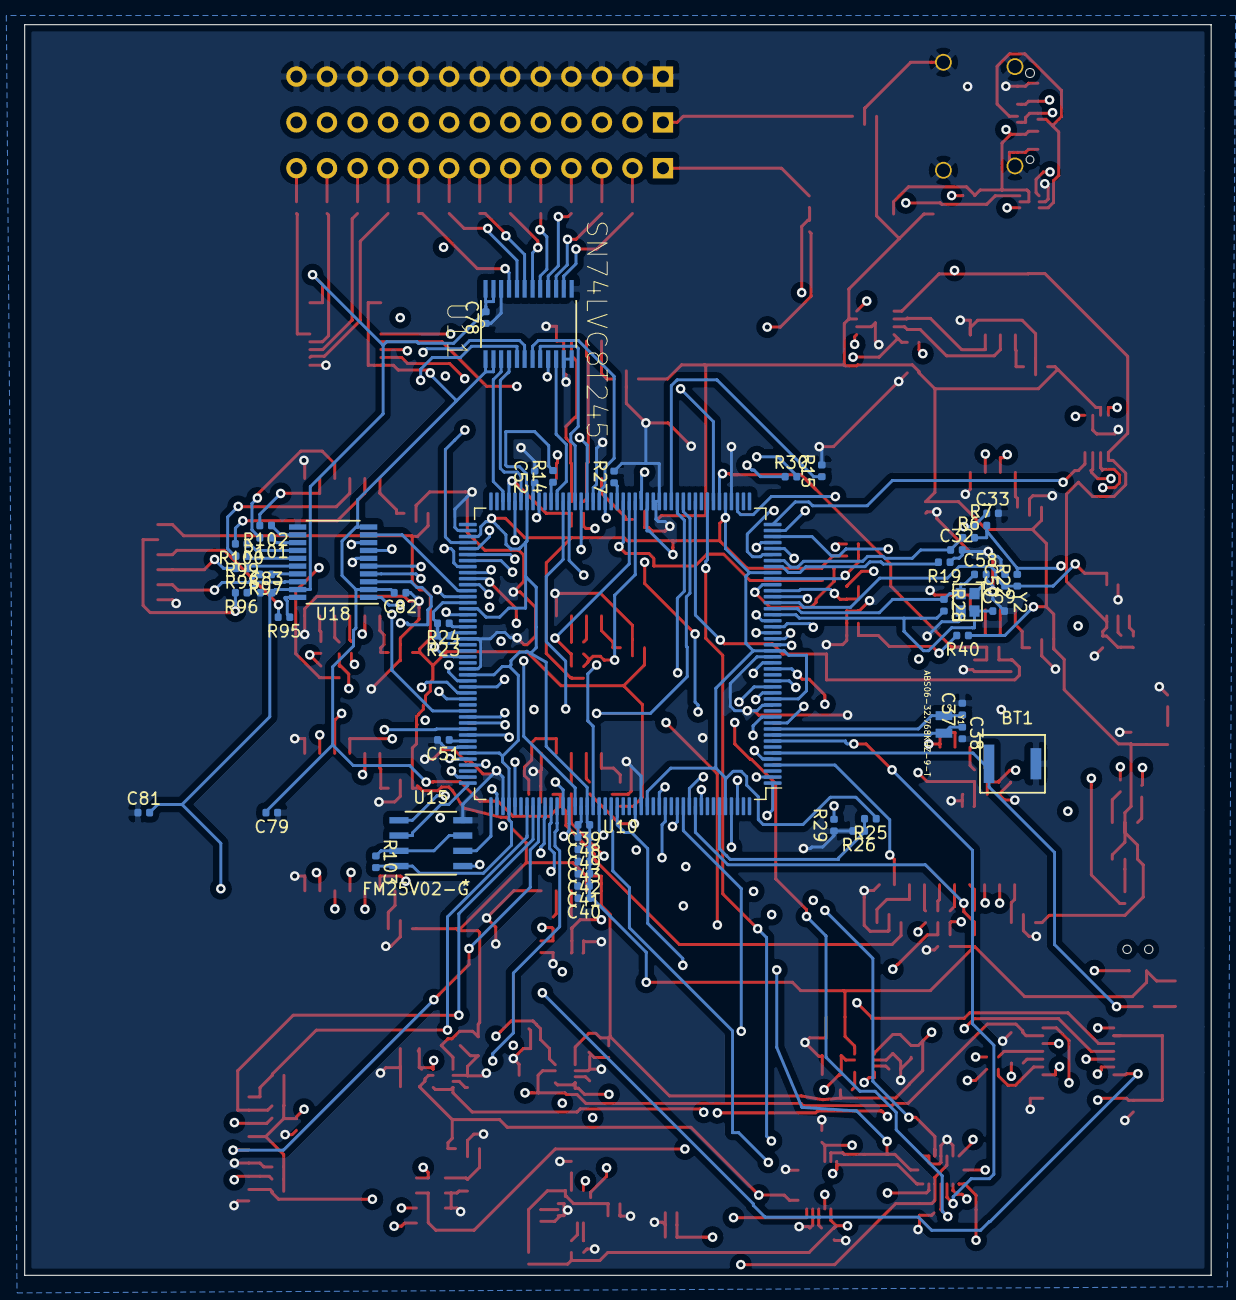
[picture p13: board Flight_Controller.kicad_pcb from below]

Board: 4 copper layers, 98.7 x 104.0 mm, 233 parts (52 on the bottom side), 236 nets.
