ThaoMinhHoang/350_Flight_controller/(commit log)

2019-07-04 Create Magnetometer
2019-07-04 Magnetometer update
    [LIS3MDL_magetometer.kicad_pcb, LIS3MDL_magetometer.sch]
2019-07-05 Main Processor Update
    [Flight_Controller.kicad_pcb, Flight_Controller.sch]
2019-07-07 Update schematic to include all labels
    [Flight_Controller.kicad_pcb, Flight_Controller.sch]
2019-07-07 Added a couple of notes
2019-07-07 Added development schematics
    - Includes new connector symbols
    - Includes STM32F765IIT6 in schematic
    - Includes labeled connectors in schematic
    [Flight_Controller.kicad_pcb, Flight_Controller.sch]
2019-07-15 Begun labelling connectors with pinout document
    [Flight_Controller.sch]
2019-08-01 ICM20689 Kidfile
    [20689.kicad_pcb, 20689.sch]
2019-08-08 Power Supply
    Power supply for pixhawk 4 along with a few external power connectors and connections
    [PowerSupply.kicad_pcb, PowerSupply.sch]
2019-08-08 update IST8310, DPS422
    [DPS422.kicad_pcb, DPS422.sch, IST8310.kicad_pcb, IST8310.sch]
2019-08-08 Hope for the best
    [20689.sch]
2019-08-08 Hole for the best 2
    [BMI088.sch]
2019-08-12 Updated Wiring
    - 3 Sensors connected, some might need to change. Definitely needs to be double-checked at some point.
    - All labels are now global
    [Flight_Controller.sch]
2019-08-12 Crystal oscillator circuit added
    [Flight_Controller.sch]
2019-08-13 wiring updates
    [Flight_Controller.sch]
2019-08-14 Updated power connections
    All power components have been connected to the appropriate places
    [Flight_Controller.sch]
2019-08-15 Organised layout of schematic
    [Flight_Controller.sch]
2019-08-21 Minor changes
    [Flight_Controller.sch]
2019-08-21 Sensor & FRAM Update
    [Flight_Controller.sch]
2019-08-22 Finished Sensors, Fixed PMU
    [Flight_Controller.sch]
2019-08-22 barometer update
    [MS5611-01BA03.kicad_pcb, MS5611-01BA03.sch]
2019-08-22 Finished FRAM, Added CHECK notes, Updated Osc.
    [Flight_Controller.sch]
2019-08-29 Massive Update
    - Sensors
    - Processor
    - Power Management
    - Peer Checking
    - Lots more
    [Flight_Controller.sch]
2019-08-31 Updates on footprints
    Missing footprints: connectors, sensors
2019-08-31 footprint lib
    [EDI2CAP.CFG, NX3225SA-24.000M-STD-CSR-3.stl, NX3225SA-24.000M-STD-CSR-3.stp, chips.prt, nx3225sa12000mhzstdcsr1.psm]
2019-09-02 Updated schematics, added USB-C Port, etc.
    [Flight_Controller.sch]
2019-09-02 Move footprints to main folder
2019-09-02 Added footprints
    Added footprints into dedicated library and applied to corresponding component
2019-09-03 Stability update, ensuring all files are up to date
    [Flight_Controller.sch]
2019-09-05 Feature Update!
    + Data Translation, CAN Bus, I2C Rail, ADC Rail
    + SD Card ready to merge
    + New Formatting (Clean up)
    [Flight_Controller.sch]
2019-09-05 Merged Status LED and SD Card
    [Flight_Controller.sch]
2019-09-05 Finished Ports
    [Flight_Controller.sch]
2019-09-05 Schematics 99% Finished
    + Double check capacitor values
    + Clarify VBAT connection
    [Flight_Controller.sch]
2019-09-05 Finished Schematics.
    [Flight_Controller.sch]
2019-09-05 Error Fixing
    [Flight_Controller.sch]
2019-09-05 + New Footprints, Started PCB
    [Flight_Controller.kicad_pcb, Flight_Controller.sch]
2019-09-14 footprint update
    Found in Newfootprint folder
    [Flight_Controller.sch]
2019-09-18 Complete footprints
    [Flight_Controller.sch]
2019-09-19 Connector Update
2019-09-19 Footprint Update
2019-09-19 PCB Started
    [Flight_Controller.kicad_pcb, Flight_Controller.sch]
2019-09-26 PCB layout edit
2019-09-26 PCB layout editting
2019-09-26 PCB Routing Update
    [Flight_Controller.kicad_pcb, Flight_Controller.sch]
2019-09-27 PCB Routing 27 Sep
    [Flight_Controller.kicad_pcb, Flight_Controller.sch]
2019-09-28 Added EMI LC Footprint
2019-09-28 PCB 4 layers, 89 unrouted
    [Flight_Controller.kicad_pcb, Flight_Controller.sch]
2019-09-29 Completed all PCB connections
    [Flight_Controller.kicad_pcb]
2019-09-30 Shrunt PCB size to 100x100mm
    [Flight_Controller.kicad_pcb]
2019-09-30 Shrunk PCB size to 100x100mm
2019-10-08 PCB GND Fill fix
    Hopefully it doesn't break this time..
    [Flight_Controller.kicad_pcb]
2019-10-08 Updated some capacitor footprints
    Updated footprints from from 0402_1005 to 0603_1608, still need to do a lot more
    [Flight_Controller.kicad_pcb, Flight_Controller.sch]
2019-10-08 Completely updated capacitor footprints
    [Flight_Controller.kicad_pcb]
2019-10-13 Fixed all PCB errors
    Ready to print!
    [Flight_Controller.kicad_pcb]
